ArminJo/SoftStart/extras/SoftstartEmbedded.sch

## EAGLE design extras/SoftstartEmbedded.sch (2021-06-18)

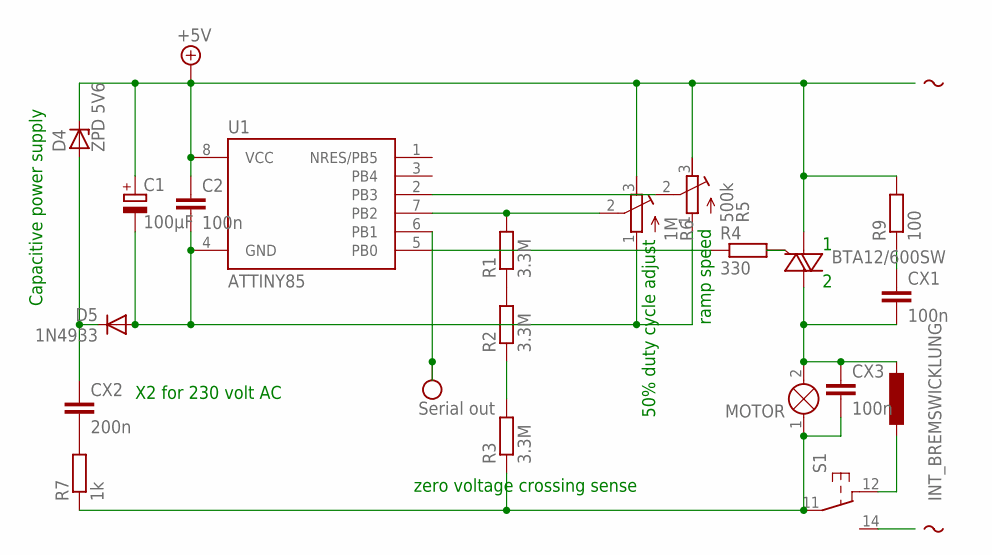
[picture p10: schematic SoftstartEmbedded.sch]

Parts:
BTA12/600SW: BT138-H; TO220BH
C1: 100µF; E7,5-16
C2: 100n; C025-025X050
CX1, CX3: 100n; XC15B5
CX2: 200n; XC15B5
D4: ZPD 5V6; DO35Z10
D5: 1N4933; DO41-10
INT_BREMSWICKLUNG: L-EUIR-2; IR-2
MOTOR: SIGNALLAMPE; LAMPE
R1, R2, R3: 3.3M; 0207/10
R4: 330; 0207/10
R5: 500k; RTRIM4G/J
R6: 1M; RTRIM4G/J
R7: 1k; 0207/10
R9: 100; 0207/10
S1: DRUCK-WECHSELSCHALTER
U1: ATTINY85; PDIP08_300MIL

Connections:
+5V: BTA12/600SW.T1 (A1), C1.+, C2.1, D4.C, R5.3 (E), R6.3 (E), R9.2, U1.8 (VCC)
unnamed: R1.1, R2.2
unnamed: R2.1, R3.2
unnamed: R1.2, R6.2 (S), U1.7 (PB2)
unnamed: CX2.1, D4.A, D5.C
unnamed: CX2.2, R7.2
unnamed: CX3.2, MOTOR.1 (X1), R3.1, R7.1, S1.11
unnamed: BTA12/600SW.G, R4.2
unnamed: R4.1, U1.5 (PB0)
unnamed: BTA12/600SW.T2 (A2), CX1.2, CX3.1, INT_BREMSWICKLUNG.1, MOTOR.2 (X2)
unnamed: CX1.1, R9.1
unnamed: R5.2 (S), U1.2 (PB3)
unnamed: INT_BREMSWICKLUNG.2, S1.12
unnamed: C1.-, C2.2, D5.A, R5.1 (A), R6.1 (A), U1.4 (GND)

Notes on the sheet:
50% duty cycle adjust
ramp speed
zero voltage crossing sense
X2 for 230 volt AC
Capacitive power supply
