ArminJo/SoftStart/extras/SoftstartPlugIn.sch

## EAGLE design extras/SoftstartPlugIn.sch (2021-06-08)

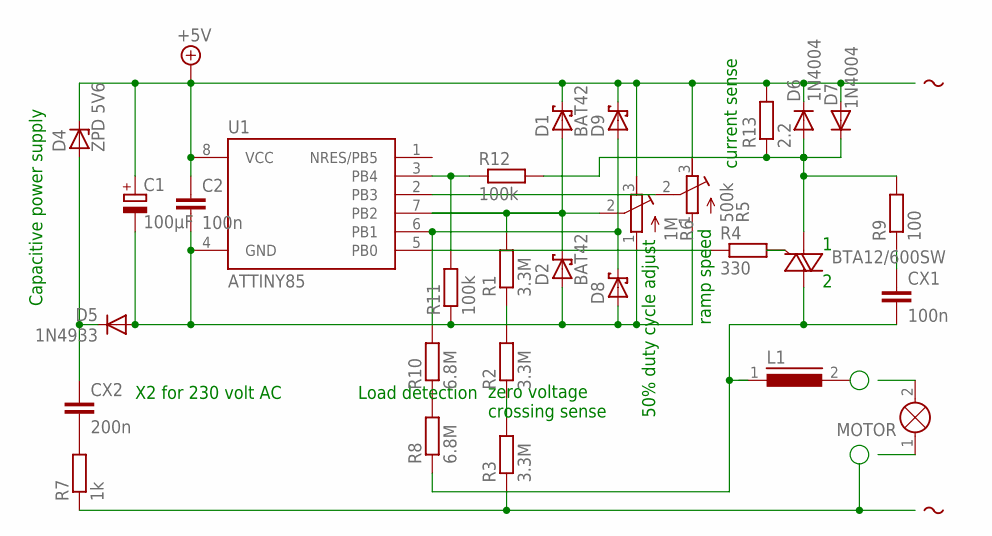
[picture p11: schematic SoftstartPlugIn.sch]

Parts:
BTA12/600SW: BT138-H; TO220BH
C1: 100µF; E7,5-16
C2: 100n; C025-025X050
CX1: 100n; XC15B5
CX2: 200n; XC15B5
D1, D2, D8, D9: BAT42; DO35-10
D4: ZPD 5V6; DO35Z10
D5: 1N4933; DO41-10
D6, D7: 1N4004; DO41-10
L1: 82114A
MOTOR: SIGNALLAMPE; LAMPE
R1, R2, R3: 3.3M; 0207/10
R4: 330; 0207/10
R5: 500k; RTRIM4G/J
R6: 1M; RTRIM4G/J
R7: 1k; 0207/10
R8, R10: 6.8M; 0207/10
R9: 100; 0207/10
R11, R12: 100k; 0207/10
R13: 2.2; 0207/10
U1: ATTINY85; PDIP08_300MIL

Connections:
+5V: C1.+, C2.1, D1.C, D4.C, D6.C, D7.A, D9.C, R5.3 (E), R6.3 (E), R13.2, U1.8 (VCC)
unnamed: R1.1, R2.2
unnamed: R2.1, R3.2
unnamed: D1.A, R1.2, R6.2 (S), U1.7 (PB2)
unnamed: R11.2, R12.1, U1.3 (PB4)
unnamed: CX2.1, D4.A, D5.C
unnamed: CX2.2, R7.2
unnamed: R3.1, R7.1
unnamed: BTA12/600SW.G, R4.2
unnamed: R4.1, U1.5 (PB0)
unnamed: BTA12/600SW.T1 (A1), D6.A, D7.C, R9.2, R12.2, R13.1
unnamed: CX1.1, R9.1
unnamed: R5.2 (S), U1.2 (PB3)
unnamed: R8.2, R10.1
unnamed: C1.-, C2.2, D2.A, D5.A, D8.A, D8.C, D9.A, R5.1 (A), R6.1 (A), R10.2, R11.1, U1.4 (GND), U1.6 (PB1)
unnamed: BTA12/600SW.T2 (A2), CX1.2, R8.1

Notes on the sheet:
50% duty cycle adjust
ramp speed
current sense
Load detection
X2 for 230 volt AC
Capacitive power supply
zero voltage crossing sense
