ArminJo/SoftStart/src/TRIACRamp.h

/*
 * TRIACRamp.h
 *
 *  Copyright (C) 2018  Armin Joachimsmeyer
 *  Email: armin.joachimsmeyer@gmail.com
 *  License: GPL v3 (http://www.gnu.org/licenses/gpl.html)
 *
 */
/*
 * Definitions for Attiny85
 */

#ifndef _TRIAC_RAMP_H
#define _TRIAC_RAMP_H

#include "ATtinyUtils.h" // for TIMER1_CLOCK_DIVIDER_FOR_8_MICROS etc.
#include "LongUnion.h"
#include <stdint.h>

//#define DEBUG // for debug output
#define INFO  // enabled by default. Enables calibration mode. for info output - delay, load detaching values
//#define ERROR   // print error output - count overflow/missing zero crossing trigger
#include "DebugLevel.h"  // Propagate debug level

// if used for 60 Hz instead of 50 Hz mains activate the next line
//#define MAINS_HAVE_60_HZ

//
// ATMEL ATTINY85
//
//                                        +-\/-+
//                  RESET ADC0 (D5) PB5  1|    |8  Vcc
// USB+   Ramp Duration - ADC3 (D3) PB3  2|    |7  PB2 (D2) INT0/ADC1 - Zero voltage Crossing Sense
// USB-   Current Sense - ADC2 (D4) PB4  3|    |6  PB1 (D1) MISO/DO/AIN1/OC0B/OC1A/PCINT1 - TX Debug output - (Digispark) LED
//                                  GND  4|    |5  PB0 (D0) OC0A - TRIAC Control
//                                        +----+
//

/*
 * PIN and ADC channel definitions
 */
#define TRIACControlOutput PB0          // active LOW
#define ZeroVoltageDetectionInput PB2   // generates interrupts at both edges

#define LoadDetectionVoltageInputADCChannel 2
#define ALLOWED_DELTA_NO_LOAD_LSB 10
#define PERIODS_THRESHOLD_FOR_LOAD_DETACHED 25 // periods without a load until off
#define PERIODS_THRESHOLD_FOR_LOAD_ATTACHED 4 // periods with a load until on

// Check for -DTX_PIN=PB1 compile parameter. Not required if ATtinySerialOut.hpp is included.
#if defined(TX_PIN) && (PB1 != TX_PIN)
#error TX pin must be PB1.
#endif
/*
 * Timer definitions
 */
#define TIMER0_COUNTER_TOP 0xFF
#define TIMER0_FAST_PWM ((1 << WGM01) | (1 << WGM00))

#define TIMER_VALUE_FOR_FULL_POWER TIMER0_COUNTER_TOP // this value must be > TIMER_COUNT_AT_ZERO_CROSSING
#define OCRA_VALUE_FOR_NO_POWER 0xFE // this value must be != TIMER_VALUE_FOR_FULL_POWER and > TIMER_COUNT_AT_ZERO_CROSSING

#if (F_CPU == 1000000)
#define TIMER0_CLOCK_CYCLE_MICROS 64
#define TIMER0_CLOCK_DIVIDER_BITS TIMER0_CLOCK_DIVIDER_FOR_64_MICROS

#elif (F_CPU == 8000000)
#define TIMER0_CLOCK_CYCLE_MICROS 128
#define TIMER0_CLOCK_DIVIDER_BITS TIMER0_CLOCK_DIVIDER_FOR_128_MICROS

#else
#error F_CPU value must be 1000000 or 8000000.
#endif

#if defined(MAINS_HAVE_60_HZ)
#define HALF_WAVES_PER_SECOND 120
#else
#define HALF_WAVES_PER_SECOND 100
#endif

#define MICROSECONDS_PER_HALF_WAVE (1000000L / HALF_WAVES_PER_SECOND)
// TOTAL_HALF_WAVE_TIMER_COUNT values are:
// 0x82. 130 * 64 us gives 8320 microseconds for 60 Hz
// 0x9C. 156 * 64 us gives 9984 microseconds for 50 Hz
// 0x4E. 78 * 128 us gives 9984 microseconds for 50 Hz
#define TOTAL_HALF_WAVE_TIMER_COUNT (MICROSECONDS_PER_HALF_WAVE / TIMER0_CLOCK_CYCLE_MICROS)

#define TIMER_COUNT_AT_ZERO_CROSSING (TOTAL_HALF_WAVE_TIMER_COUNT - 1) // 155 for 50 Hz. -1 since we start timer with 0xFF

// for plausibility check of voltage zero crossing detection. 6 => ~2 Hz/380 usec
#define ALLOWED_DELTA_PHASE_SHIFT_COUNT 6

/*
 * GENERAL definitions
 */
// for synchronizing and measurement of mains period after power up - must be an even number
#define SYNCHRONIZING_CYCLES (2*4)

/*
 * Trigger impulse timing
 */
#define TIMER1_CLOCK_DIVIDER                    TIMER1_CLOCK_DIVIDER_FOR_8_MICROS // gives max 2 ms trigger pulse
#define TRIAC_PULSE_TIMER_CLOCK_CYCLE_MICROS    8

/*
 *  Length of trigger pulse - 100 us is too small for my circuit
 */
#define TRIAC_PULSE_WIDTH_MICROS 250

/*
 * Amount of multiple trigger pulses if delay is less than total time of multiple pulses
 * This avoids flickering at small loads
 */
#define TRIAC_PULSE_NUMBERS 3

/*
 * Length of break between (multiple) trigger pulses
 */
#define TRIAC_PULSE_BREAK_MICROS 400

// Initial delay of TRIAC trigger impulse.
// Values from 0 - 180 degrees, but the extremes make no sense
#define START_PHASE_SHIFT_DEGREES 160

#define START_PHASE_SHIFT_MARGIN_COUNT ((TOTAL_HALF_WAVE_TIMER_COUNT * (180 - START_PHASE_SHIFT_DEGREES)) / 180)
#if (START_PHASE_SHIFT_DEGREES < 45)
#error START_PHASE_SHIFT_DEGREES below 45 degree makes no sense.
#endif
#define START_PHASE_SHIFT_MARGIN_MICROS (((1000000 / HALF_WAVES_PER_SECOND) * (180 - START_PHASE_SHIFT_DEGREES)) / 180) // only used for plausi below
#if  (TRIAC_PULSE_WIDTH_MICROS > (START_PHASE_SHIFT_MARGIN_MICROS + 20))
#error START_PHASE_SHIFT_DEGREES is too high. The TRIAC pulse may reach the next half wave
#endif

/*
 * Timer0 count at end of ramp.
 * For load detection it must be > 2 (128 us or 2.3 degree).
 * Voltage is 9 volt @230 AC
 *
 */
#define MINIMUM_PHASE_SHIFT_COUNT 2

/*
 * States of the state machine
 */
#define TRIAC_CONTROL_STATE_STOP 0
#define TRIAC_CONTROL_STATE_OUTPUT_COUNTER 1 // output timer counter value forever in order to adjust the 50% duty cycle trimmer
#define TRIAC_CONTROL_STATE_WAIT_FOR_SETTLING 2
#define TRIAC_CONTROL_STATE_RAMP_UP 3
#define TRIAC_CONTROL_STATE_FULL_POWER 4
/*
 * Calibration mode is entered, when the ADC value from the ramp speed trimmer is less than 4.
 * Output timer counter value forever in order to adjust the 50% duty cycle trimmer for the mains 50/60 Hz trigger generation.
 */
#define TRIAC_CONTROL_STATE_CALIBRATION 10

struct RampControlStruct {
    volatile uint8_t SoftStartState;

    uint8_t NextOCRA; // Next Timer value to be set - if equals 0xFF then no delay is assumed => TRIAC_CONTROL_STATE_FULL_POWER
    /*
     * Since the counter has a resolution of 64 us (and you can see this brightness steps) we use this to get a finer resolution.
     */
    uint8_t NextMicrosecondsDelayForTriggerPulse;
    uint8_t MicrosecondsDelayForTriggerPulse;

    uint8_t TRIACPulseCount; //counts multiple TRIAC pulses
#if defined(INFO)
    volatile uint8_t TimerCountAtTriggerPulse;
    // Signal to loop() to write ramp data
    volatile bool DoWriteRampData;
#endif
    /*
     * Ramp computation
     * Delay has 3 byte resolution.
     * The MidHighByte byte is directly used for Timer OCRA.
     * The MidLowByte is used for microseconds delay.
     * The LowByte is used to increase the resolution to enable long ramps.
     */
    LongUnion TimerCountForTriggerDelayShift16; // only used for RAMP
    uint32_t DelayDecrementPerHalfWaveShift16; // amount of delay to be subtracted from RampControl.TimerCountForTriggerDelayShift16 each half wave.

    /*
     * The measured count of Timer0 at zero crossing of one half wave.
     * Computed by settling phase.
     */
    uint8_t MainsHalfWaveTimerCount; // Used twice. Once at startup and once at beginning of full power state
    volatile uint16_t MainsHalfWaveTimerCountAccumulated;
    uint8_t HalfWaveCounterIntern; // counts half waves to determine end of settling phase

#if defined(LOAD_ON_OFF_DETECTION)
    uint16_t NoLoadADCReferenceValue;
    bool isLoadAttached;
    bool isLoadAttachedStateJustChanged;
    int8_t NoLoadFoundCount; // Counter to determine if load is attached or detached
#endif

    /*
     * derived timer used by loop()
     */
    volatile uint16_t HalfWaveCounterForExternalTiming;
    // Signal to loop() that interrupt has occurred and new half wave begins
    volatile bool HalfWaveJustStarted;
};
extern RampControlStruct RampControl;

void initRampControl();
void setRampDurationSeconds(uint16_t aRampDurationSeconds);
void setRampDurationMillis(uint32_t aRampDurationMillis);
void startRamp();
void stopRamp();
void switchToFullPower();
void checkAndHandleCounterOverflowForLoop();
void printRampInfo();
void StartTriacPulse();

#ifdef __cplusplus
extern "C" {
#endif
// must be provided by Arduino library or own code
void delayMicroseconds(unsigned int us);
#ifdef __cplusplus
} // extern "C"
#endif

#endif // _TRIAC_RAMP_H
