ArminJo/SoftStart/examples/SoftStart/SoftStart.ino

/*
 * SoftStart.cpp
 *
 * Generates Triac control pulses for SoftStart of series motors.
 *
 *  Copyright (C) 2015  Armin Joachimsmeyer
 *  Email: armin.joachimsmeyer@gmail.com
 *
 *  This file is part of SoftStart https://github.com/ArminJo/SoftStart.
 *
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
 * No delay() or millis() or micros() are used, leaving both timers for TRIAC signal generation.
 *
 * Calibration mode is only available if INFO is defined (default).
 * It is entered by setting ramp speed to 0 (slow).
 * It outputs actual phase counter forever (at 115200 Baud (@1MHZ) at pin 6 / PB1) in order to adjust the 50% duty cycle trimmer.
 * Calibration mode can be ended only by reset.
 *
 * Voltage trigger interrupt is only enabled if load is attached.
 *
 * FUSE VALUES for LOAD_ON_OFF_DETECTION which means that CPU power is always on.
 * You may use the default values or enable additional Brown-out detection eg. at 4.3 volt.
 * Low=0X62 (default) Int RC Osc. 8 MHz divided by 8. 14 Clk + 64 ms startup.
 * High=0XDC BrowOut at VCC=4.3 volt
 * Extended=0XFF (default)
 *
 * FUSE VALUES for embedded version, which requires fast start, since soft start must begin as soon as power is on -> 14 Clk + Enable BOD
 * Low=0X52 Int RC Osc. 8 MHz divided by 8 (default). 14 Clk + 4 ms startup (for fast startup).
 * High=0XDC BrowOut at VCC=4.3 volt
 * Extended=0XFF (default)
 *
 */

#include "TRIACRamp.h"

#include "ATtinyUtils.h"
#include "ADCUtils.hpp"
#include "digitalWriteFast.h"

#if defined(INFO)
#define TX_PIN PB1 // must be defined before the include
#include "ATtinySerialOut.hpp" // Available as Arduino library "ATtinySerialOut"
#endif

#include <avr/interrupt.h>
#include <math.h>   // for pow and log10f

//#define LOAD_ON_OFF_DETECTION // Do not start with ramp at boot up time, but wait for interrupt at LoadDetectionInput pin 6.

#define VERSION_EXAMPLE "2.0"

//
// ATMEL ATTINY85
//
//                                        +-\/-+
//                  RESET ADC0 (D5) PB5  1|    |8  Vcc
// USB+   Ramp Duration - ADC3 (D3) PB3  2|    |7  PB2 (D2) INT0/ADC1 - Zero voltage Crossing Sense
// USB-   Current Sense - ADC2 (D4) PB4  3|    |6  PB1 (D1) MISO/DO/AIN1/OC0B/OC1A/PCINT1 - TX Debug output - (Digispark) LED
//                                  GND  4|    |5  PB0 (D0) OC0A - TRIAC Control
//                                        +----+

#if defined(LOAD_ON_OFF_DETECTION) && defined(INFO)
#  if defined(__AVR_ATtiny25__) || defined(__AVR_ATtiny45__)
#error Code size of this example is too large to fit in an ATtiny 25 or 45. deactivate #define LOAD_ON_OFF_DETECTION or deactivate #define INFO in TRIACRamp.h to shrink the code for an ATtiny45.
#  endif
#endif

// PIN 2 /PB3 is used to read ramp duration
#define RampDurationADCChannel 3
/*
 * Maximum ADC value to switch to calibration mode to adjust external trimmer to 50% duty cycle
 */
#define CALIBRATION_MODE_MAX_ADC_VALUE 4

/*
 * RAMP timing
 */
void readRampDelay(); // Value is read from PIN 3 and converted to value between 10 and 1000
// RampControl.DelayDecrement of 0x3E8 gives a 0.3 second ramp (34 zero crossings) from delay start value of 132 to 0
// RampControl.DelayDecrement of 0x100 gives a 1.3 second ramp (132 zero crossings) from delay start value of 132 to 0
// RampControl.DelayDecrement of 0x40 gives a 5 second ramp (528 zero crossings) from delay start value of 132 to 0
// RampControl.DelayDecrement of 0x10 gives a 20 second ramp from delay start value of 132 to 0
// RampControl.DelayDecrement of 0x01 gives a 5 minutes ramp from delay start value of 132 to 0

/***********************************************************************************
 * Code starts here
 ***********************************************************************************/
void setup(void) {

#if defined(INFO)
    initTXPin();
    useCliSeiForStrings(true);
#endif

    initRampControl();

    // disable digital input buffer for ADC inputs to save power
    DIDR0 = (1 << ADC3D) | (1 << ADC2D);

#if defined(INFO)
    // Print before debug output is switched to input
    // 35 characters which takes 3,3 millis at 115200 baud
    writeString(F("START " __FILE__ "\nVersion " VERSION_EXAMPLE " from " __DATE__ "\n"));
#endif

#if defined(LOAD_ON_OFF_DETECTION)
    // here we are right after power on, so wait for external inputs to settle
    delay4CyclesInlineExact(0xFFFF);
    /*
     * Read reference value for zero current
     */
#  if defined(INFO)
    writeString(F("NoLoadADCReferenceValue="));
    writeUnsignedInt(RampControl.NoLoadADCReferenceValue);
    write1Start8Data1StopNoParity('\n');
#  endif
#else // LOAD_ON_OFF_DETECTION
    /*
     * Start ramp immediately
     */
    readRampDelay();
    startRamp();
#endif // LOAD_ON_OFF_DETECTION

#if defined(INFO)
    /*
     * Read value from external trimmer now in order to check for calibration mode (value < CALIBRATION_MODE_MAX_ADC_VALUE)
     */
    if (readADCChannelWithOversample(RampDurationADCChannel, 4) < CALIBRATION_MODE_MAX_ADC_VALUE) {
        writeString(F("Activate calibration mode\n"));
        // This overwrites all previous states set by startRamp() or setLoadDetached()
        RampControl.SoftStartState = TRIAC_CONTROL_STATE_CALIBRATION;
    }
#endif

    interrupts(); // Enable interrupts
}

void loop(void) {

#if defined(LOAD_ON_OFF_DETECTION)
    /*
     * Handle load attached / detached
     */
    if (RampControl.isLoadAttachedStateJustChanged) {
        RampControl.isLoadAttachedStateJustChanged = false;

        if (RampControl.isLoadAttached) {
            // Load attached, stop triggering TRIAC and reset state
#if defined(INFO)
            writeString(F("Start\n"));
#endif
            // get maybe changed value for next turn
            readRampDelay();
            startRamp();
        } else {
            //Load detached, stop triggering TRIAC and reset state
            stopRamp();
#if defined(INFO)
            writeString(F("Switch OFF and wait for load attached\n"));
#endif
        }
    }
#endif

    checkAndHandleCounterOverflowForLoop();

#if defined(INFO)
    printRampInfo();
#endif

}

/*
 * Read ramp duration. Use x^2 function to get better resolution at low input values.
 * convert to 0 -> 5 second ramp
 */
void readRampDelay() {
    float tValue = readADCChannelWithOversample(RampDurationADCChannel, 4);
    tValue = tValue / (1024 / 1.2); // gives range 0,00469 to 1.8 since input values < 4 leads to test mode
    tValue = tValue + 1.8; // gives range 1.80469 to 3
    uint32_t tRampMillis = pow(17, tValue); // gives 163,78 to 4913
    setRampDurationMillis(tRampMillis);
#if defined(INFO)
    writeString(F("Ramp="));
    writeLong(tRampMillis);
    writeString(F(" ms\n"));
//    writeString(" ms\ncomputed DelayDecrementPerHalfWaveShift16=");
//    writeLong(RampControl.DelayDecrementPerHalfWaveShift16);
//    write1Start8Data1StopNoParity('\n');
#endif
}
