ArminJo/SoftStart/(commit log)

2018-04-24 Initial Arduino library version
2020-11-16 Minor changes and documentation
    [Softstart.sch]
2021-06-18 Improved load detection
    [SoftstartEmbedded.sch]
